alexDickhans/self-cap/images/board-iso.png

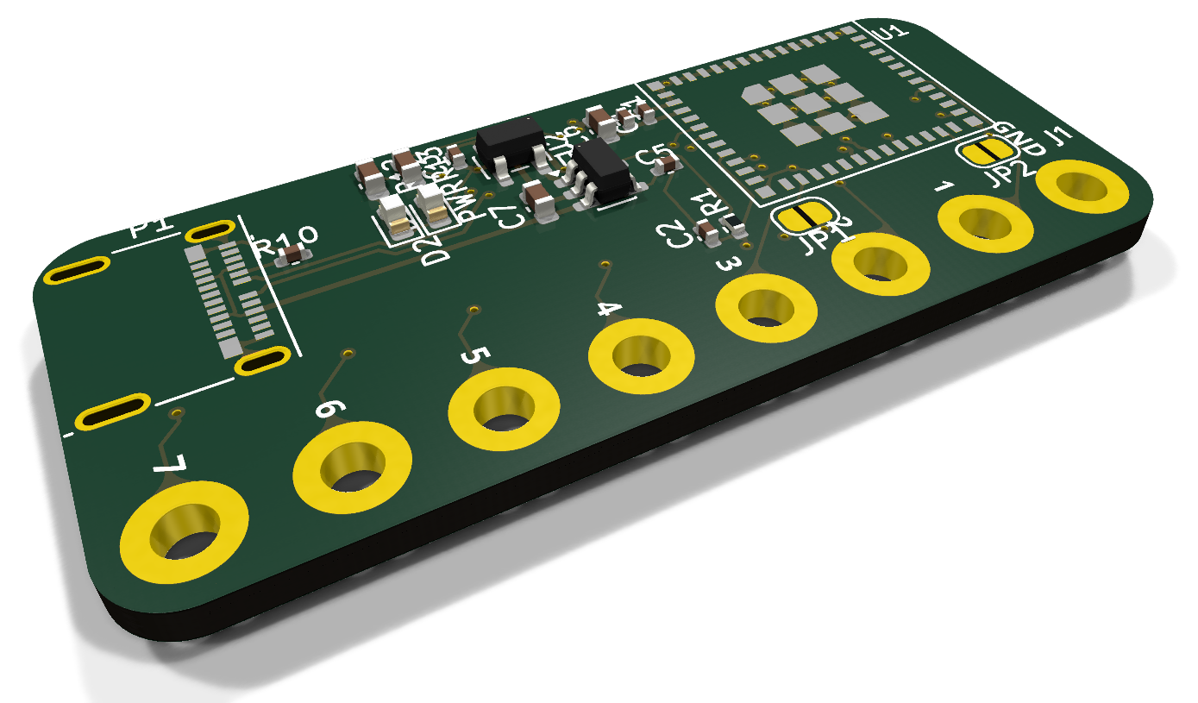
images/board-iso.png
