alexDickhans/self-cap/production/bom.csv

Designator | Comment | Footprint | Qty | LCSC Part #
C1 | 10uF | 0402 | 1 | C15525
C2,C3,C4 | 100nF | 0402 | 3 | C1525
C5 | 10nF | 0402 | 1 | C15195
C6,C7 | 22uF | 0603 | 2 | C59461
D1,D2 | LED | 0603 | 2 | C2286
J2 | JST PH 2-pin | JST-PH-SMD-2 | 1 | C295747
P1 | USB-C receptacle | Molex-105450-0101 | 1 | C134092
R1 | 100k | 0402 | 1 | C25741
R2 | 1k | 0402 | 1 | C11702
R10 | 5.1k | 0402 | 1 | C25905
R12,R13 | 330 | 0603 | 2 | C23138
U1 | ESP32-C6-MINI-1 | ESP32-C6-MINI-1 | 1 | C5736265
U2 | MAX40200AUK | SOT-23-5 | 1 | C47118006
U3 | SPX3819M5-L-3-3 | SOT-23-5 | 1 | C9055
