alexDickhans/self-cap/self-cap.step

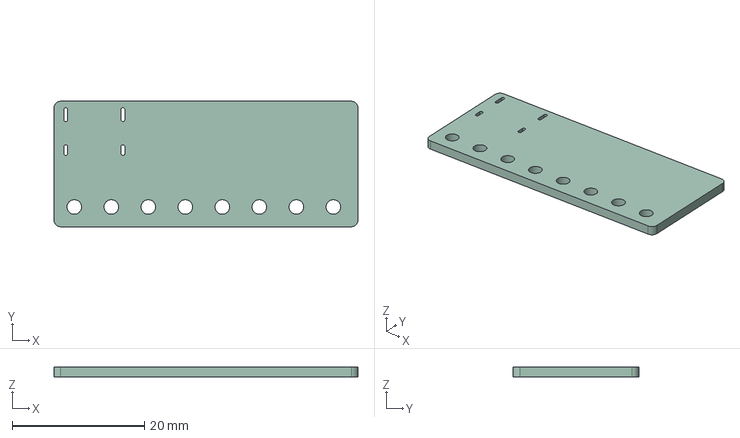
[picture p5: CAD file, 2025-11-10]
self-cap.step
46.0 x 19.0 x 1.52 mm
