alexDickhans/self-cap/self-cap.kicad_pcb

## KiCad design self-cap.kicad_pcb (2026-11-04)

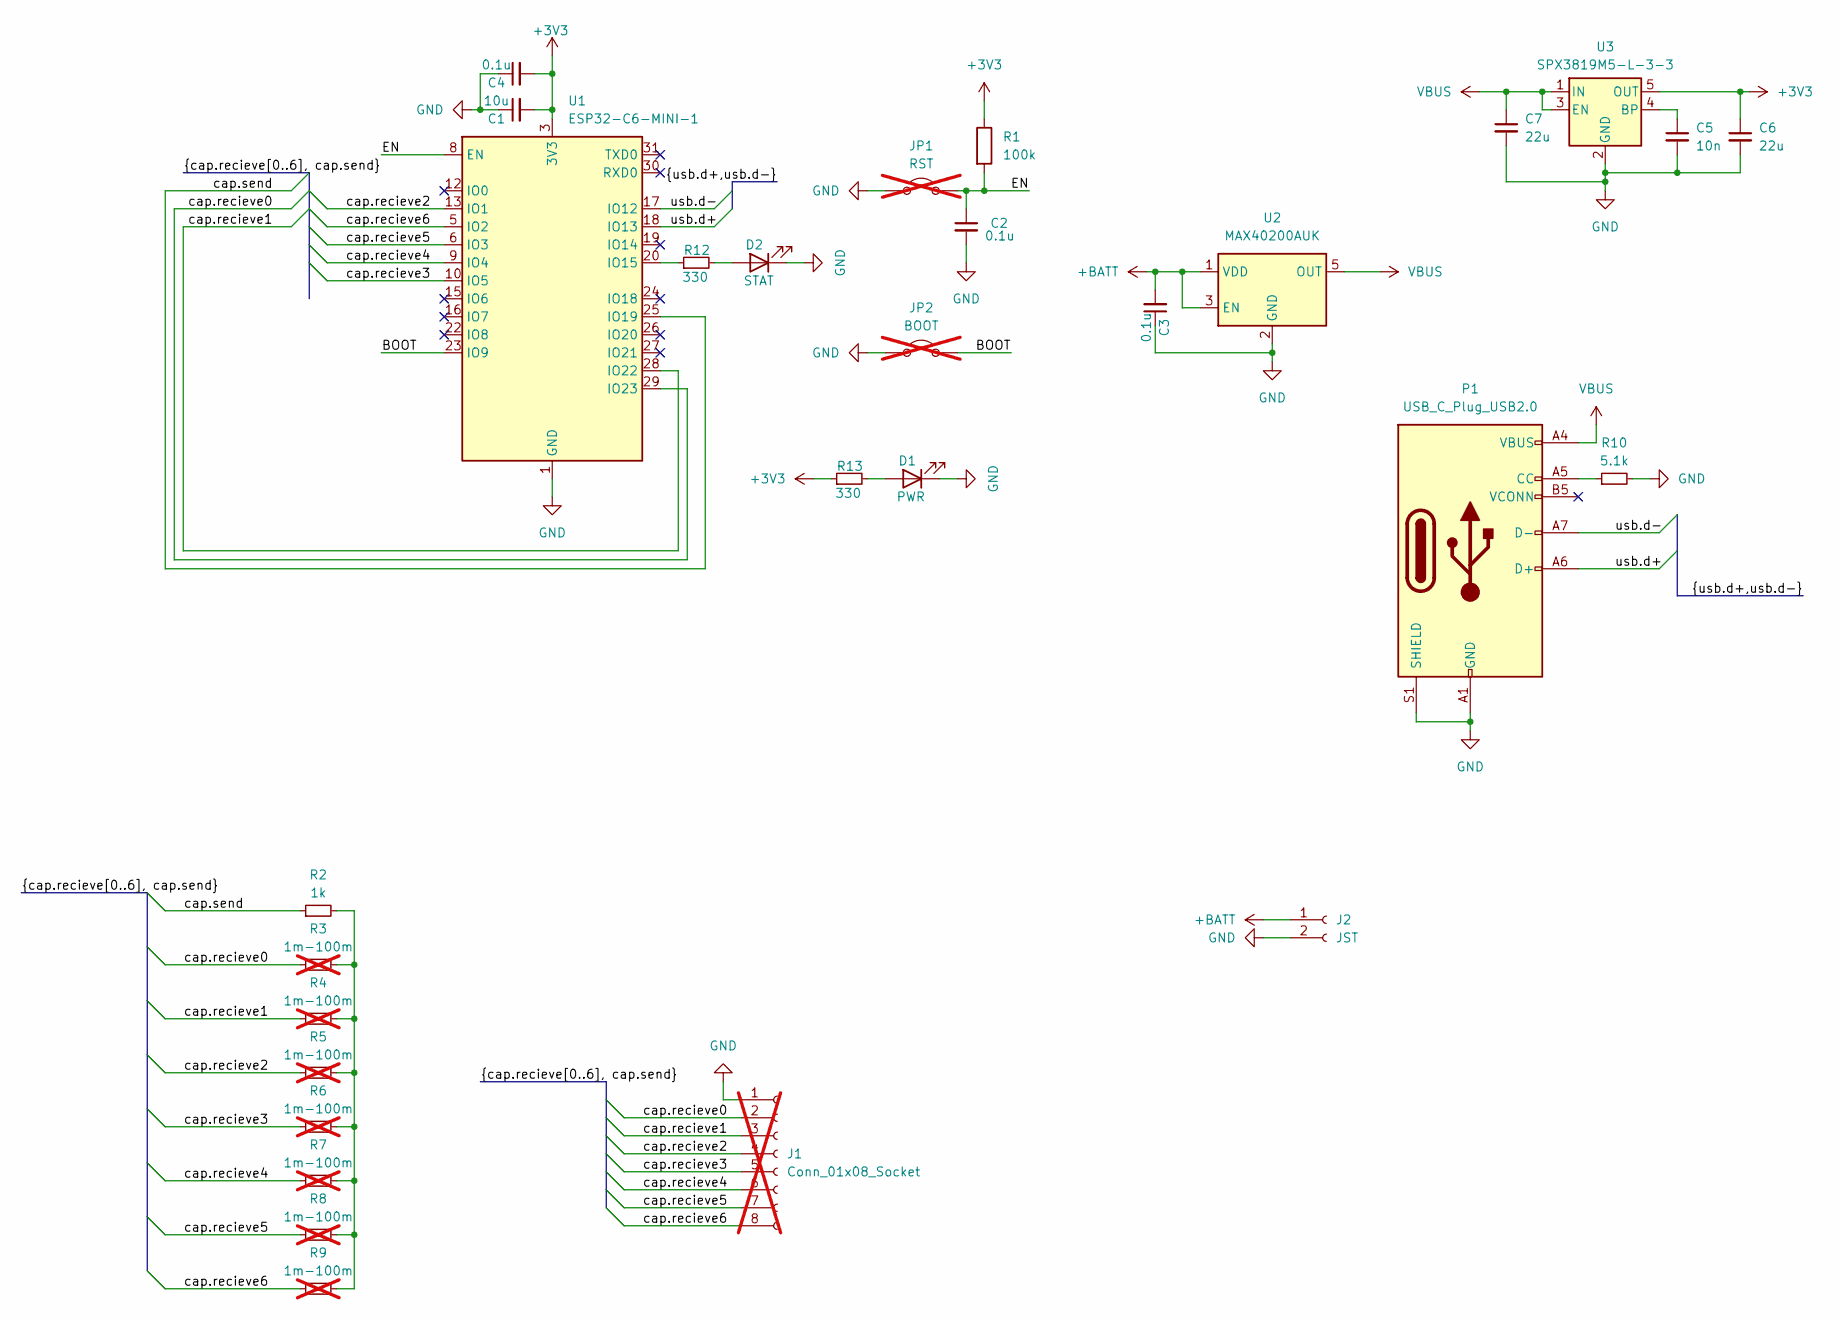
[picture p6: schematic self-cap.kicad_sch]

Parts:
C1: 10u; C_0402_1005Metric; LCSC Part # C15525
C2, C3, C4: 0.1u; C_0402_1005Metric; LCSC Part # C1525
C5: 10n; C_0402_1005Metric; LCSC Part # C15195
C6, C7: 22u; C_0603_1608Metric; LCSC Part # C59461
D1: PWR; LED_0603_1608Metric; LCSC Part # C2286
D2: STAT; LED_0603_1608Metric; LCSC Part # C2286
J1: Conn_01x08_Socket; self-cap-connn; not fitted
J2: JST; JST_PH_S2B-PH-SM4-TB_1x02-1MP_P2.00mm_Horizontal; LCSC Part # C295747
JP1: RST; SolderJumper-2_P1.3mm_Open_RoundedPad1.0x1.5mm; not fitted
JP2: BOOT; SolderJumper-2_P1.3mm_Open_RoundedPad1.0x1.5mm; not fitted
P1: USB_C_Plug_USB2.0; USB_C_Receptacle_Molex_105450-0101; LCSC Part # C134092
R1: 100k; R_0402_1005Metric; LCSC Part # C25741
R2: 1k; R_0402_1005Metric; LCSC Part # C11702
R3, R4, R5, R6, R7, R8, R9: 1m-100m; C_0402_1005Metric; LCSC Part # C131554; not fitted
R10: 5.1k; C_0402_1005Metric; LCSC Part # C25905
R12, R13: 330; C_0603_1608Metric; LCSC Part # C23138
U1: ESP32-C6-MINI-1; LCSC Part # C5736265
U2: MAX40200AUK; SOT-23-5; LCSC Part # C47118006
U3: SPX3819M5-L-3-3; SOT-23-5; LCSC Part # C9055

Connections:
+3V3: C1.2, C4.2, C6.1, R1.1, R13.1, U1.3 (3V3), U3.5 (OUT)
+BATT: C3.2, J2.1, U2.1 (VDD), U2.3 (EN)
/BOOT: JP2.2 (B), U1.23 (IO9)
/EN: C2.1, JP1.2 (B), R1.2, U1.8 (EN)
/cap.recieve0: J1.2, R3.1, U1.29 (IO23)
/cap.recieve1: J1.3, R4.1, U1.28 (IO22)
/cap.recieve2: J1.4, R5.1, U1.13 (IO1)
/cap.recieve3: J1.5, R6.1, U1.10 (IO5)
/cap.recieve4: J1.6, R7.1, U1.9 (IO4)
/cap.recieve5: J1.7, R8.1, U1.6 (IO3)
/cap.recieve6: J1.8, R9.1, U1.5 (IO2)
/cap.send: R2.1, U1.25 (IO19)
/usb.d+: P1.A6 (D+), U1.18 (IO13)
/usb.d-: P1.A7 (D-), U1.17 (IO12)
GND: C1.1, C2.2, C3.1, C4.1, C5.2, C6.2, C7.2, D1.1 (K), D2.1 (K), J1.1, J2.2, JP1.1 (A), JP2.1 (A), P1.A1 (GND), P1.A12 (GND), P1.B1 (GND), P1.B12 (GND), P1.S1 (SHIELD), R10.2, U1.1 (GND), U1.2 (GND), U1.11 (GND), U1.14 (GND), U1.36 (GND), U1.37 (GND), U1.38 (GND), U1.39 (GND), U1.40 (GND), U1.41 (GND), U1.42 (GND), U1.43 (GND), U1.44 (GND), U1.45 (GND), U1.46 (GND), U1.47 (GND), U1.48 (GND), U1.49 (GND), U1.50 (GND), U1.51 (GND), U1.52 (GND), U1.53 (GND), U2.2 (GND), U3.2 (GND)
unnamed: D1.2 (A), R13.2
unnamed: D2.2 (A), R12.2
unnamed: P1.A5 (CC), R10.1
unnamed: R2.2, R3.2, R4.2, R5.2, R6.2, R7.2, R8.2, R9.2
unnamed: R12.1, U1.20 (IO15)
unnamed: C5.1, U3.4 (BP)
VBUS: C7.1, P1.A4 (VBUS), P1.A9 (VBUS), P1.B4 (VBUS), P1.B9 (VBUS), U2.5 (OUT), U3.1 (IN), U3.3 (EN)

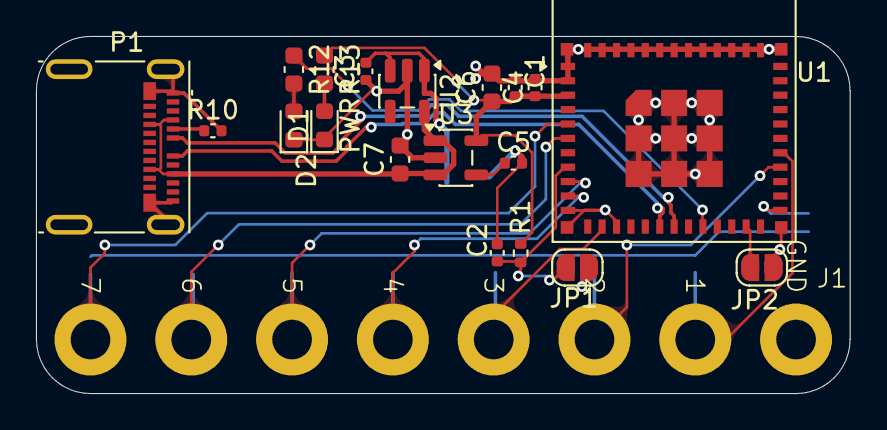
[picture p7: board self-cap.kicad_pcb from above]

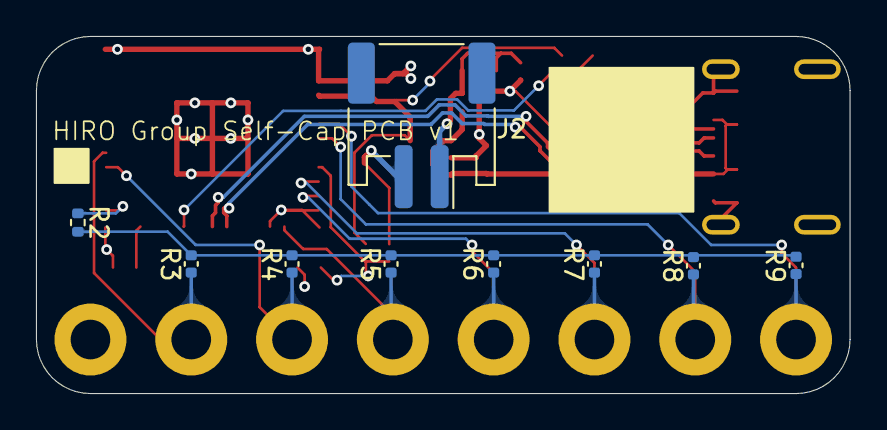
[picture p8: board self-cap.kicad_pcb from below]

Board: 4 copper layers, 45.2 x 19.8 mm, 29 parts (9 on the bottom side), 22 nets.
