alexDickhans/self-cap/(commit log)

2025-11-17 Switching directions
    [res.kicad_sch, self-cap.kicad_pcb, self-cap.kicad_sch]
2026-02-05 V3 revisions
    [bom.csv, designators.csv, positions.csv, self-cap.kicad_pcb, self-cap.kicad_sch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]
2026-02-06 Remove lock files
    [self-cap.kicad_pcb]
2026-11-04 Add a release README and fabrication files for the current board.
    The previous gerber package predated the V3 schematic, and KiCad backups were checked in. One electrode hole was duplicated in the drill file.
    [bom.csv, designators.csv, positions.csv, self-cap.kicad_pcb]
